namlit/Keyboard_PCB/Keyboard.kicad_pcb

## KiCad design Keyboard.kicad_pcb (2016-03-09)

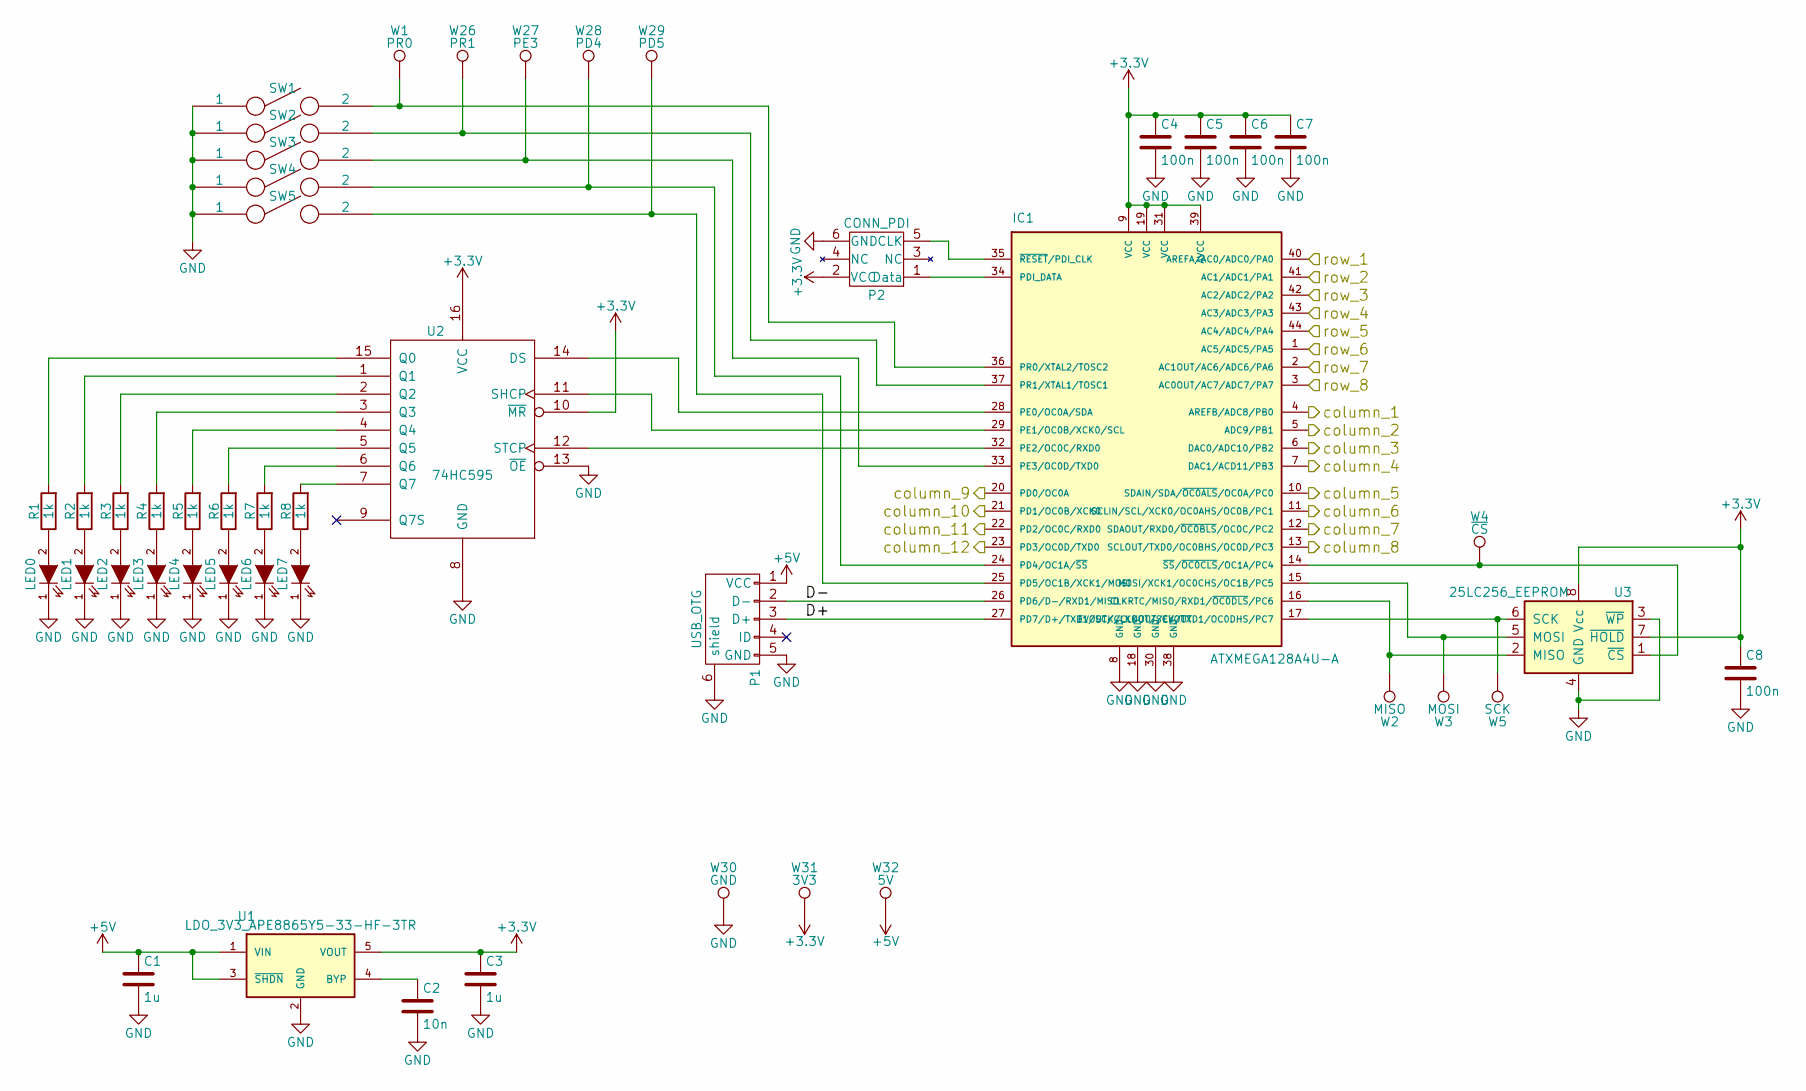
[picture p1: schematic keyboard_controller.sch]

Parts:
C1, C3: 1u; C_0603_HandSoldering; Manufacturer Part Number CL10B105KO8NNNC
C2: 10n; C_0603_HandSoldering; Manufacturer Part Number CL10B103KC8NNNC
C4, C5, C6, C7, C8: 100n; C_0603_HandSoldering; Manufacturer Part Number CL10B104KO8NNNC
IC1: ATXMEGA128A4U-A; TQFP_44_0.8mmPitch_handSoldering; Manufacturer Part Number ATXMEGA128A4U-AU
LED0, LED1, LED2, LED3, LED4, LED5: LED; LED_0603; Manufacturer Part Number LL-S194PUGC-2B
LED6, LED7: LED; LED_0603; Manufacturer Part Number LL-S194PVC-V1-2B
P1: USB_OTG; micro_USB_1981568-1; Manufacturer Part Number 1981568-1
P2: CONN_PDI; Pin_Header_Straight_2x03; Manufacturer Part Number T821106A1S100CEU
R1, R2, R3, R4, R5, R6, R7, R8: 1k; R_0603_HandSoldering; Manufacturer Part Number RC0603JR-071K
SW1, SW2, SW3, SW4, SW5: SPST; SPST_TACTM-613N-F; Manufacturer Part Number TACTM-613N-F
U1: LDO_3V3_APE8865Y5-33-HF-3TR; SOT-23-5; Manufacturer Part Number APE8865Y5-33-HF-3TR
U2: 74HC595; SOIC-16_3.9x9.9mm_Pitch1.27mm; Manufacturer Part Number 74HC595D.118
U3: 25LC256_EEPROM; SOIC-8_3.9x4.9mm_Pitch1.27mm; Manufacturer Part Number 25LC256-I/SN
W1: PR0; Measurement_Point_Round-TH_Big
W2: MISO; Measurement_Point_Round-TH_Big
W3: MOSI; Measurement_Point_Round-TH_Big
W4: ~CS; Measurement_Point_Round-TH_Big
W5: SCK; Measurement_Point_Round-TH_Big
W26: PR1; Measurement_Point_Round-TH_Big
W27: PE3; Measurement_Point_Round-TH_Big
W28: PD4; Measurement_Point_Round-TH_Big
W29: PD5; Measurement_Point_Round-TH_Big
W30: GND; Measurement_Point_Round-TH_Big
W31: 3V3; Measurement_Point_Round-TH_Big
W32: 5V; Measurement_Point_Round-TH_Big

Connections:
+3V3: C3.1, C4.1, C5.1, C6.1, C7.1, C8.1, IC1.9 (VCC), IC1.19 (VCC), IC1.31 (VCC), IC1.39 (AVCC), P2.2 (VCC), U1.5 (VOUT), U2.10 (~MR), U2.16 (VCC), U3.7 (~HOLD), U3.8 (Vcc), W31.1
+5V: C1.1, P1.1 (VCC), U1.1 (VIN), U1.3 (~SHDN~), W32.1
/keyboard_controller/D+: IC1.27 (PD7/D+/TXD1/SCK/CLKOUT/EVOUT), P1.3 (D+)
/keyboard_controller/D-: IC1.26 (PD6/D-/RXD1/MISO), P1.2 (D-)
/keyboard_controller/column_1: IC1.4 (AREFB/ADC8/PB0); also elsewhere on the board
/keyboard_controller/column_2: IC1.5 (ADC9/PB1); also elsewhere on the board
/keyboard_controller/column_3: IC1.6 (DAC0/ADC10/PB2); also elsewhere on the board
/keyboard_controller/column_4: IC1.7 (DAC1/ACD11/PB3); also elsewhere on the board
/keyboard_controller/column_5: IC1.10 (SDAIN/SDA/~OC0ALS~/OC0A/PC0); also elsewhere on the board
/keyboard_controller/column_6: IC1.11 (SCLIN/SCL/XCK0/OC0AHS/OC0B/PC1); also elsewhere on the board
/keyboard_controller/column_7: IC1.12 (SDAOUT/RXD0/~OC0BLS~/OC0C/PC2); also elsewhere on the board
/keyboard_controller/column_8: IC1.13 (SCLOUT/TXD0/OC0BHS/OC0D/PC3); also elsewhere on the board
/keyboard_controller/column_9: IC1.20 (PD0/OC0A); also elsewhere on the board
/keyboard_controller/column_10: IC1.21 (PD1/OC0B/XCK0); also elsewhere on the board
/keyboard_controller/column_11: IC1.22 (PD2/OC0C/RXD0); also elsewhere on the board
/keyboard_controller/column_12: IC1.23 (PD3/OC0D/TXD0); also elsewhere on the board
/keyboard_controller/row_1: IC1.40 (AREFA/AC0/ADC0/PA0); also elsewhere on the board
/keyboard_controller/row_2: IC1.41 (AC1/ADC1/PA1); also elsewhere on the board
/keyboard_controller/row_3: IC1.42 (AC2/ADC2/PA2); also elsewhere on the board
/keyboard_controller/row_4: IC1.43 (AC3/ADC3/PA3); also elsewhere on the board
/keyboard_controller/row_5: IC1.44 (AC4/ADC4/PA4); also elsewhere on the board
/keyboard_controller/row_6: IC1.1 (AC5/ADC5/PA5); also elsewhere on the board
/keyboard_controller/row_7: IC1.2 (AC1OUT/AC6/ADC6/PA6); also elsewhere on the board
/keyboard_controller/row_8: IC1.3 (AC0OUT/AC7/ADC7/PA7); also elsewhere on the board
GND: C1.2, C2.2, C3.2, C4.2, C5.2, C6.2, C7.2, C8.2, IC1.8 (GND), IC1.18 (GND), IC1.30 (GND), IC1.38 (GND), LED0.1 (K), LED1.1 (K), LED2.1 (K), LED3.1 (K), LED4.1 (K), LED5.1 (K), LED6.1 (K), LED7.1 (K), P1.5 (GND), P1.6 (shield), P2.6 (GND), SW1.1, SW2.1, SW3.1, SW4.1, SW5.1, U1.2 (GND), U2.8 (GND), U2.13 (~OE), U3.3 (~WP), U3.4 (GND), W30.1
unnamed: C2.1, U1.4 (BYP)
unnamed: IC1.14 (~SS~/~OC0CLS~/OC1A/PC4), U3.1 (~CS), W4.1
unnamed: IC1.15 (MOSI/XCK1/OC0CHS/OC1B/PC5), U3.5 (MOSI), W3.1
unnamed: IC1.16 (CLKRTC/MISO/RXD1/~OC0DLS~/PC6), U3.2 (MISO), W2.1
unnamed: IC1.17 (EVOUT/CLKOUT/SCK/TXD1/OC0DHS/PC7), U3.6 (SCK), W5.1
unnamed: IC1.24 (PD4/OC1A/~SS~), SW4.2, W28.1
unnamed: IC1.25 (PD5/OC1B/XCK1/MOSI), SW5.2, W29.1
unnamed: IC1.28 (PE0/OC0A/SDA), U2.14 (DS)
unnamed: IC1.29 (PE1/OC0B/XCK0/SCL), U2.11 (SHCP)
unnamed: IC1.32 (PE2/OC0C/RXD0), U2.12 (STCP)
unnamed: IC1.33 (PE3/OC0D/TXD0), SW3.2, W27.1
unnamed: IC1.34 (PDI_DATA), P2.1 (Data)
unnamed: IC1.35 (~RESET~/PDI_CLK), P2.5 (CLK)
unnamed: IC1.36 (PR0/XTAL2/TOSC2), SW1.2, W1.1
unnamed: IC1.37 (PR1/XTAL1/TOSC1), SW2.2, W26.1
unnamed: LED0.2 (A), R1.1
unnamed: LED1.2 (A), R2.1
unnamed: LED2.2 (A), R3.1
unnamed: LED3.2 (A), R4.1
unnamed: LED4.2 (A), R5.1
unnamed: LED5.2 (A), R6.1
unnamed: LED6.2 (A), R7.1
unnamed: LED7.2 (A), R8.1
unnamed: R1.2, U2.15 (Q0)
unnamed: R2.2, U2.1 (Q1)
unnamed: R3.2, U2.2 (Q2)
unnamed: R4.2, U2.3 (Q3)
unnamed: R5.2, U2.4 (Q4)
unnamed: R6.2, U2.5 (Q5)
unnamed: R7.2, U2.6 (Q6)
unnamed: R8.2, U2.7 (Q7)

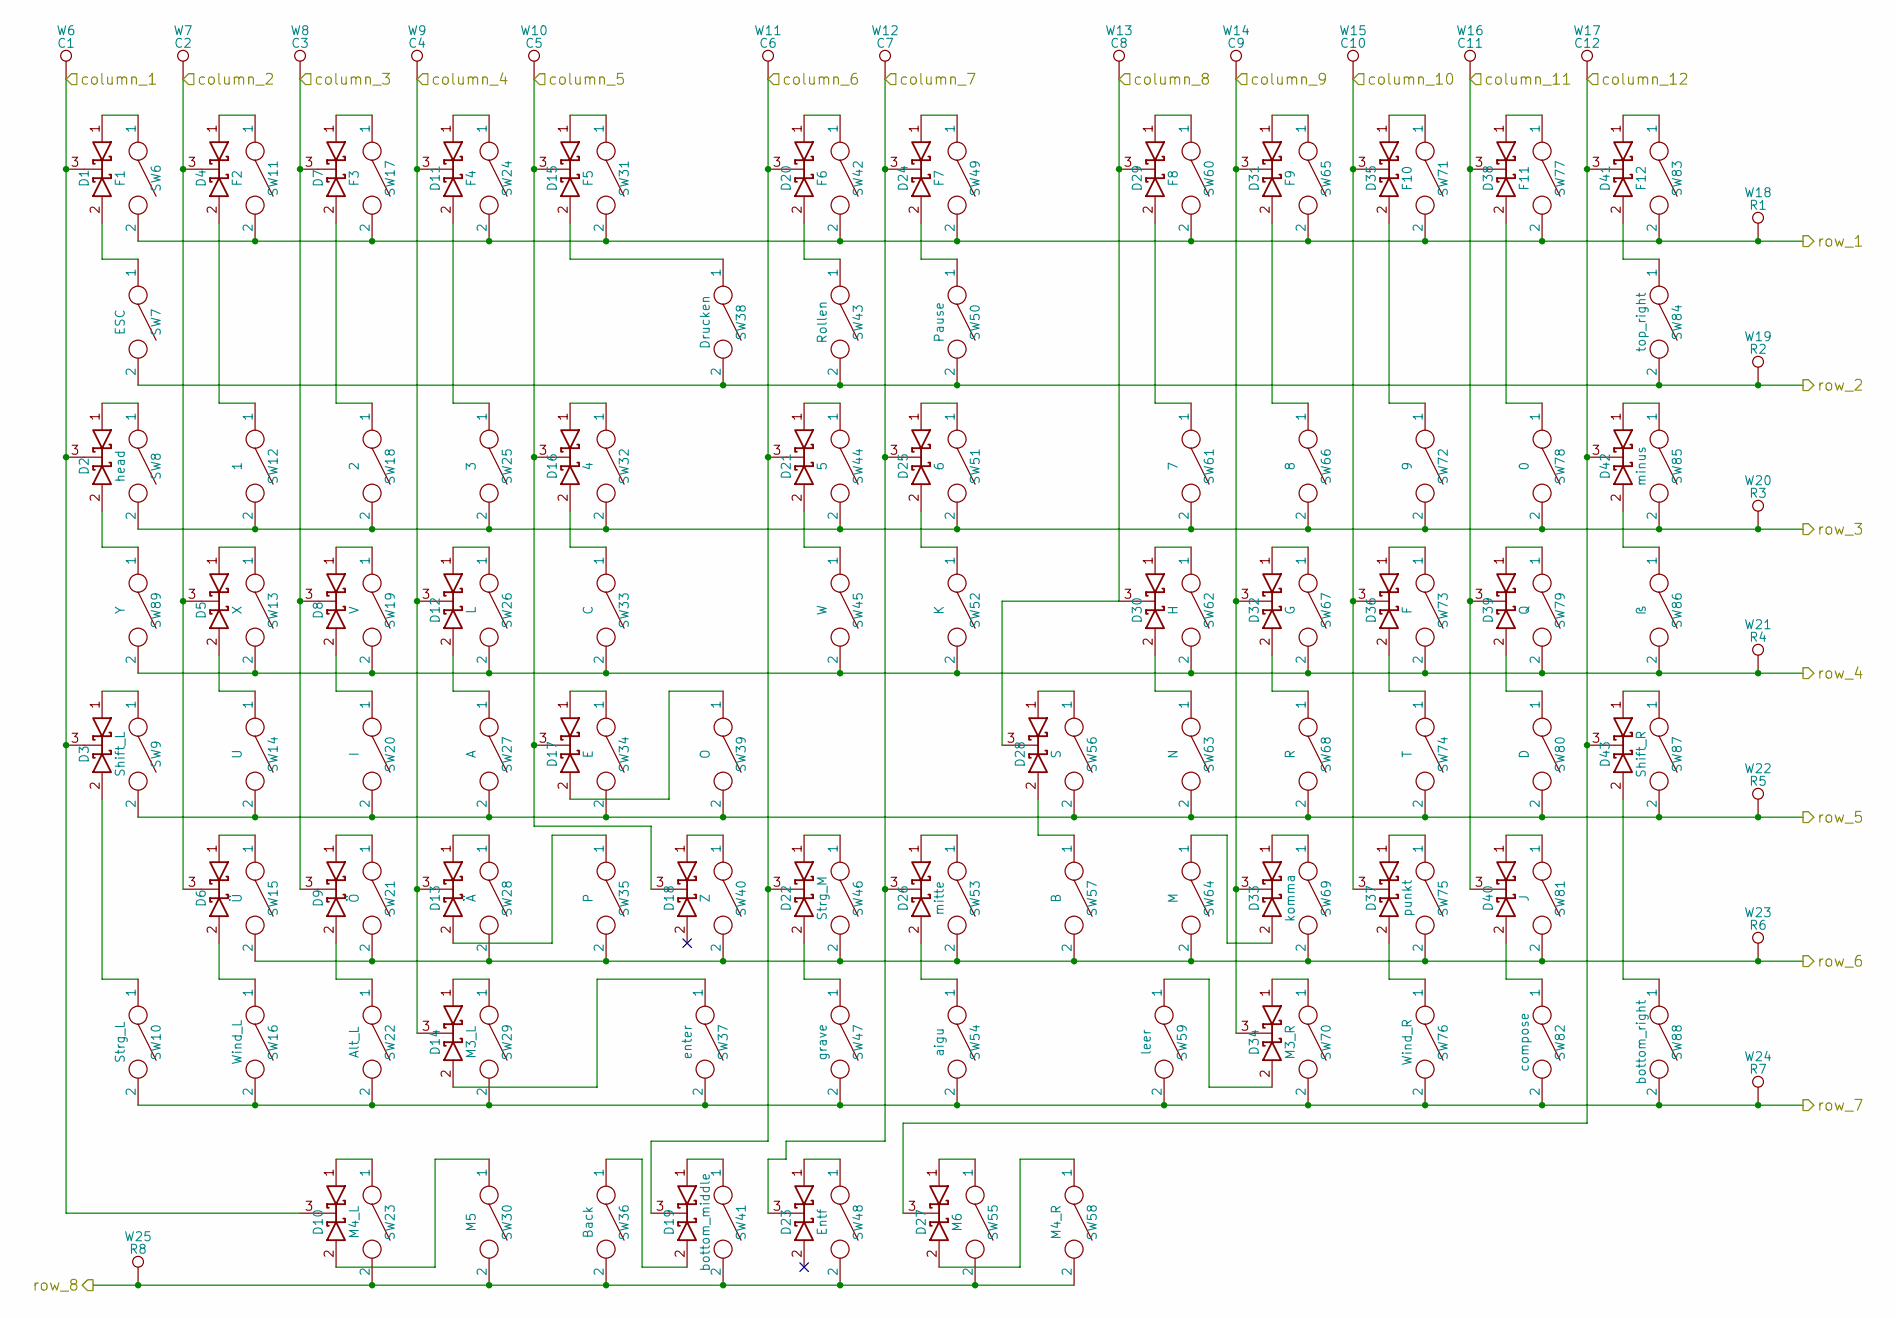
[picture p2: schematic keyboard_matrix.sch]

Parts:
D1, D2, D3, D4, D5, D6, D7, D8, D9, D10, D11, D12, D13, D14, D15, D16, D17, D18, D19, D20, D21, D22, D23, D24, D25, D26, D27, D28, D29, D30, D31, D32, D33, D34, D35, D36, D37, D38, D39, D40, D41, D42, D43: D_Schottky_x2_KCom_AAK; SOT-23; Manufacturer Part Number BAT54C.215
SW6: F1; Cherry_MX
SW7: ESC; Cherry_MX
SW8: head; Cherry_MX
SW9: Shift_L; Cherry_MX_double_vertical
SW10: Strg_L; Cherry_MX
SW11: F2; Cherry_MX
SW12: 1; Cherry_MX
SW13: X; Cherry_MX
SW14: U; Cherry_MX
SW15: Ü; Cherry_MX
SW16: Wind_L; Cherry_MX
SW17: F3; Cherry_MX
SW18: 2; Cherry_MX
SW19: V; Cherry_MX
SW20: I; Cherry_MX
SW21: Ö; Cherry_MX
SW22: Alt_L; Cherry_MX
SW23: M4_L; Cherry_MX
SW24: F4; Cherry_MX
SW25: 3; Cherry_MX
SW26: L; Cherry_MX
SW27: A; Cherry_MX
SW28: Ä; Cherry_MX
SW29: M3_L; Cherry_MX
SW30: M5; Cherry_MX
SW31: F5; Cherry_MX
SW32: 4; Cherry_MX
SW33: C; Cherry_MX
SW34: E; Cherry_MX
SW35: P; Cherry_MX
SW36: Back; Cherry_MX
SW37: enter; Cherry_MX_double_horizontal
SW38: Drucken; Cherry_MX
SW39: O; Cherry_MX
SW40: Z; Cherry_MX
SW41: bottom_middle; Cherry_MX
SW42: F6; Cherry_MX
SW43: Rollen; Cherry_MX
SW44: 5; Cherry_MX
SW45: W; Cherry_MX
SW46: Strg_M; Cherry_MX
SW47: grave; Cherry_MX
SW48: Entf; Cherry_MX
SW49: F7; Cherry_MX
SW50: Pause; Cherry_MX
SW51: 6; Cherry_MX
SW52: K; Cherry_MX
SW53: mitte; Cherry_MX
SW54: aigu; Cherry_MX
SW55: M6; Cherry_MX
SW56: S; Cherry_MX
SW57: B; Cherry_MX
SW58: M4_R; Cherry_MX
SW59: leer; Cherry_MX_double_horizontal
SW60: F8; Cherry_MX
SW61: 7; Cherry_MX
SW62: H; Cherry_MX
SW63: N; Cherry_MX
SW64: M; Cherry_MX
SW65: F9; Cherry_MX
SW66: 8; Cherry_MX
SW67: G; Cherry_MX
SW68: R; Cherry_MX
SW69: komma; Cherry_MX
SW70: M3_R; Cherry_MX
SW71: F10; Cherry_MX
SW72: 9; Cherry_MX
SW73: F; Cherry_MX
SW74: T; Cherry_MX
SW75: punkt; Cherry_MX
SW76: Wind_R; Cherry_MX
SW77: F11; Cherry_MX
SW78: 0; Cherry_MX
SW79: Q; Cherry_MX
SW80: D; Cherry_MX
SW81: J; Cherry_MX
SW82: compose; Cherry_MX
SW83: F12; Cherry_MX
SW84: top_right; Cherry_MX
SW85: minus; Cherry_MX
SW86: ß; Cherry_MX
SW87: Shift_R; Cherry_MX_double_vertical
SW88: bottom_right; Cherry_MX
SW89: Y; Cherry_MX
W6: C1; Measurement_Point_Round-TH_Big
W7: C2; Measurement_Point_Round-TH_Big
W8: C3; Measurement_Point_Round-TH_Big
W9: C4; Measurement_Point_Round-TH_Big
W10: C5; Measurement_Point_Round-TH_Big
W11: C6; Measurement_Point_Round-TH_Big
W12: C7; Measurement_Point_Round-TH_Big
W13: C8; Measurement_Point_Round-TH_Big
W14: C9; Measurement_Point_Round-TH_Big
W15: C10; Measurement_Point_Round-TH_Big
W16: C11; Measurement_Point_Round-TH_Big
W17: C12; Measurement_Point_Round-TH_Big
W18: R1; Measurement_Point_Round-TH_Big
W19: R2; Measurement_Point_Round-TH_Big
W20: R3; Measurement_Point_Round-TH_Big
W21: R4; Measurement_Point_Round-TH_Big
W22: R5; Measurement_Point_Round-TH_Big
W23: R6; Measurement_Point_Round-TH_Big
W24: R7; Measurement_Point_Round-TH_Big
W25: R8; Measurement_Point_Round-TH_Big

Connections:
/keyboard_controller/column_1: D1.3 (K), D2.3 (K), D3.3 (K), D10.3 (K), W6.1; also elsewhere on the board
/keyboard_controller/column_2: D4.3 (K), D5.3 (K), D6.3 (K), W7.1; also elsewhere on the board
/keyboard_controller/column_3: D7.3 (K), D8.3 (K), D9.3 (K), W8.1; also elsewhere on the board
/keyboard_controller/column_4: D11.3 (K), D12.3 (K), D13.3 (K), D14.3 (K), W9.1; also elsewhere on the board
/keyboard_controller/column_5: D15.3 (K), D16.3 (K), D17.3 (K), D18.3 (K), W10.1; also elsewhere on the board
/keyboard_controller/column_6: D19.3 (K), D20.3 (K), D21.3 (K), D22.3 (K), W11.1; also elsewhere on the board
/keyboard_controller/column_7: D23.3 (K), D24.3 (K), D25.3 (K), D26.3 (K), W12.1; also elsewhere on the board
/keyboard_controller/column_8: D28.3 (K), D29.3 (K), D30.3 (K), W13.1; also elsewhere on the board
/keyboard_controller/column_9: D31.3 (K), D32.3 (K), D33.3 (K), D34.3 (K), W14.1; also elsewhere on the board
/keyboard_controller/column_10: D35.3 (K), D36.3 (K), D37.3 (K), W15.1; also elsewhere on the board
/keyboard_controller/column_11: D38.3 (K), D39.3 (K), D40.3 (K), W16.1; also elsewhere on the board
/keyboard_controller/column_12: D27.3 (K), D41.3 (K), D42.3 (K), D43.3 (K), W17.1; also elsewhere on the board
/keyboard_controller/row_1: SW6.2, SW11.2, SW17.2, SW24.2, SW31.2, SW42.2, SW49.2, SW60.2, SW65.2, SW71.2, SW77.2, SW83.2, W18.1; also elsewhere on the board
/keyboard_controller/row_2: SW7.2, SW38.2, SW43.2, SW50.2, SW84.2, W19.1; also elsewhere on the board
/keyboard_controller/row_3: SW8.2, SW12.2, SW18.2, SW25.2, SW32.2, SW44.2, SW51.2, SW61.2, SW66.2, SW72.2, SW78.2, SW85.2, W20.1; also elsewhere on the board
/keyboard_controller/row_4: SW13.2, SW19.2, SW26.2, SW33.2, SW45.2, SW52.2, SW62.2, SW67.2, SW73.2, SW79.2, SW86.2, SW89.2, W21.1; also elsewhere on the board
/keyboard_controller/row_5: SW9.2, SW14.2, SW20.2, SW27.2, SW34.2, SW39.2, SW56.2, SW63.2, SW68.2, SW74.2, SW80.2, SW87.2, W22.1; also elsewhere on the board
/keyboard_controller/row_6: SW15.2, SW21.2, SW28.2, SW35.2, SW40.2, SW46.2, SW53.2, SW57.2, SW64.2, SW69.2, SW75.2, SW81.2, W23.1; also elsewhere on the board
/keyboard_controller/row_7: SW10.2, SW16.2, SW22.2, SW29.2, SW37.2, SW47.2, SW54.2, SW59.2, SW70.2, SW76.2, SW82.2, SW88.2, W24.1; also elsewhere on the board
/keyboard_controller/row_8: SW23.2, SW30.2, SW36.2, SW41.2, SW48.2, SW55.2, SW58.2, W25.1; also elsewhere on the board
unnamed: D1.1 (A), SW6.1
unnamed: D1.2 (A), SW7.1
unnamed: D2.1 (A), SW8.1
unnamed: D2.2 (A), SW89.1
unnamed: D3.1 (A), SW9.1
unnamed: D3.2 (A), SW10.1
unnamed: D4.1 (A), SW11.1
unnamed: D4.2 (A), SW12.1
unnamed: D5.1 (A), SW13.1
unnamed: D5.2 (A), SW14.1
unnamed: D6.1 (A), SW15.1
unnamed: D6.2 (A), SW16.1
unnamed: D7.1 (A), SW17.1
unnamed: D7.2 (A), SW18.1
unnamed: D8.1 (A), SW19.1
unnamed: D8.2 (A), SW20.1
unnamed: D9.1 (A), SW21.1
unnamed: D9.2 (A), SW22.1
unnamed: D10.1 (A), SW23.1
unnamed: D10.2 (A), SW30.1
unnamed: D11.1 (A), SW24.1
unnamed: D11.2 (A), SW25.1
unnamed: D12.1 (A), SW26.1
unnamed: D12.2 (A), SW27.1
unnamed: D13.1 (A), SW28.1
unnamed: D13.2 (A), SW35.1
unnamed: D14.1 (A), SW29.1
unnamed: D14.2 (A), SW37.1
unnamed: D15.1 (A), SW31.1
unnamed: D15.2 (A), SW38.1
unnamed: D16.1 (A), SW32.1
unnamed: D16.2 (A), SW33.1
unnamed: D17.1 (A), SW34.1
unnamed: D17.2 (A), SW39.1
unnamed: D18.1 (A), SW40.1
unnamed: D19.1 (A), SW41.1
unnamed: D19.2 (A), SW36.1
unnamed: D20.1 (A), SW42.1
unnamed: D20.2 (A), SW43.1
unnamed: D21.1 (A), SW44.1
unnamed: D21.2 (A), SW45.1
unnamed: D22.1 (A), SW46.1
unnamed: D22.2 (A), SW47.1
unnamed: D23.1 (A), SW48.1
unnamed: D24.1 (A), SW49.1
unnamed: D24.2 (A), SW50.1
unnamed: D25.1 (A), SW51.1
unnamed: D25.2 (A), SW52.1
unnamed: D26.1 (A), SW53.1
unnamed: D26.2 (A), SW54.1
unnamed: D27.1 (A), SW55.1
unnamed: D27.2 (A), SW58.1
unnamed: D28.1 (A), SW56.1
unnamed: D28.2 (A), SW57.1
unnamed: D29.1 (A), SW60.1
unnamed: D29.2 (A), SW61.1
unnamed: D30.1 (A), SW62.1
unnamed: D30.2 (A), SW63.1
unnamed: D31.1 (A), SW65.1
unnamed: D31.2 (A), SW66.1
unnamed: D32.1 (A), SW67.1
unnamed: D32.2 (A), SW68.1
unnamed: D33.1 (A), SW69.1
unnamed: D33.2 (A), SW64.1
unnamed: D34.1 (A), SW70.1
unnamed: D34.2 (A), SW59.1
unnamed: D35.1 (A), SW71.1
unnamed: D35.2 (A), SW72.1
unnamed: D36.1 (A), SW73.1
unnamed: D36.2 (A), SW74.1
unnamed: D37.1 (A), SW75.1
unnamed: D37.2 (A), SW76.1
unnamed: D38.1 (A), SW77.1
unnamed: D38.2 (A), SW78.1
unnamed: D39.1 (A), SW79.1
unnamed: D39.2 (A), SW80.1
unnamed: D40.1 (A), SW81.1
unnamed: D40.2 (A), SW82.1
unnamed: D41.1 (A), SW83.1
unnamed: D41.2 (A), SW84.1
unnamed: D42.1 (A), SW85.1
unnamed: D42.2 (A), SW86.1
unnamed: D43.1 (A), SW87.1
unnamed: D43.2 (A), SW88.1

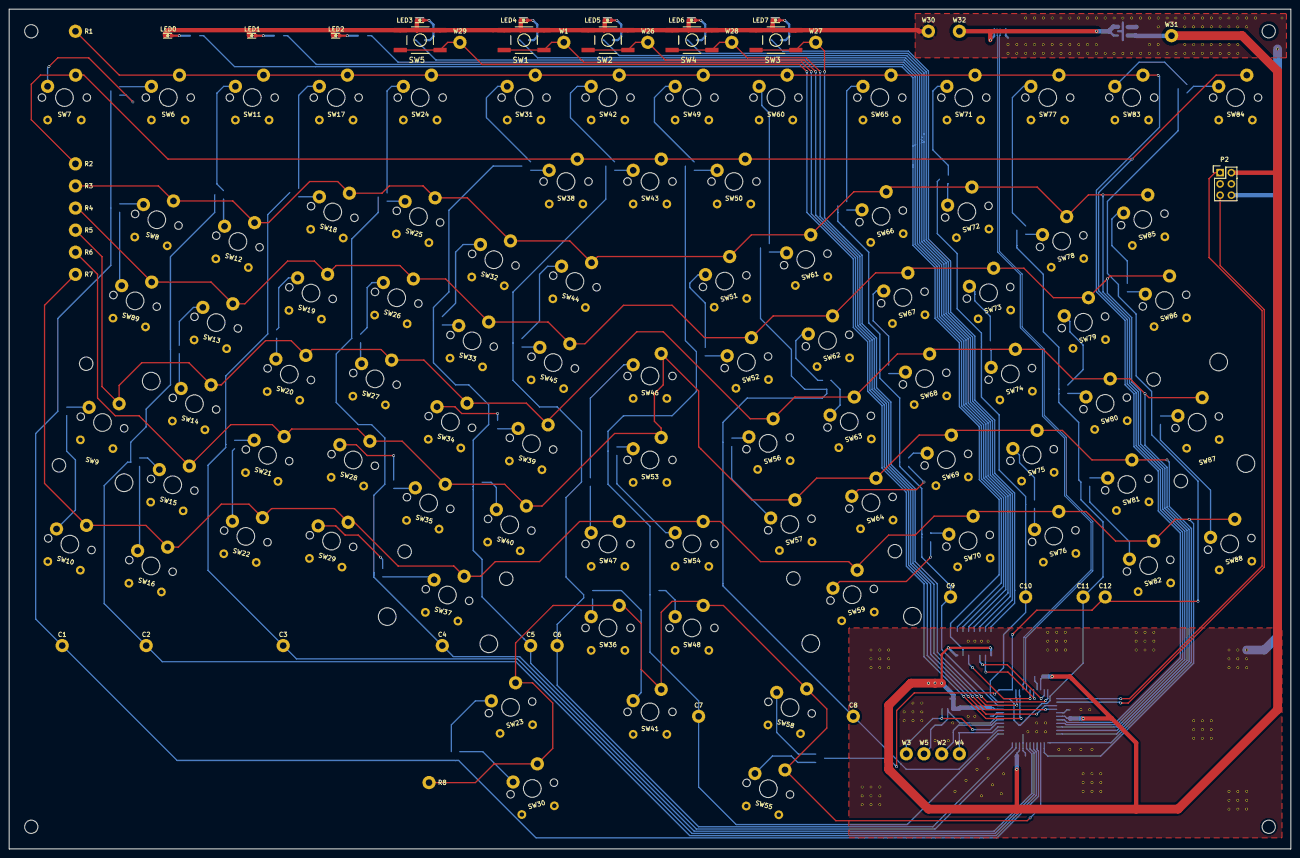
[picture p3: board Keyboard.kicad_pcb from above]

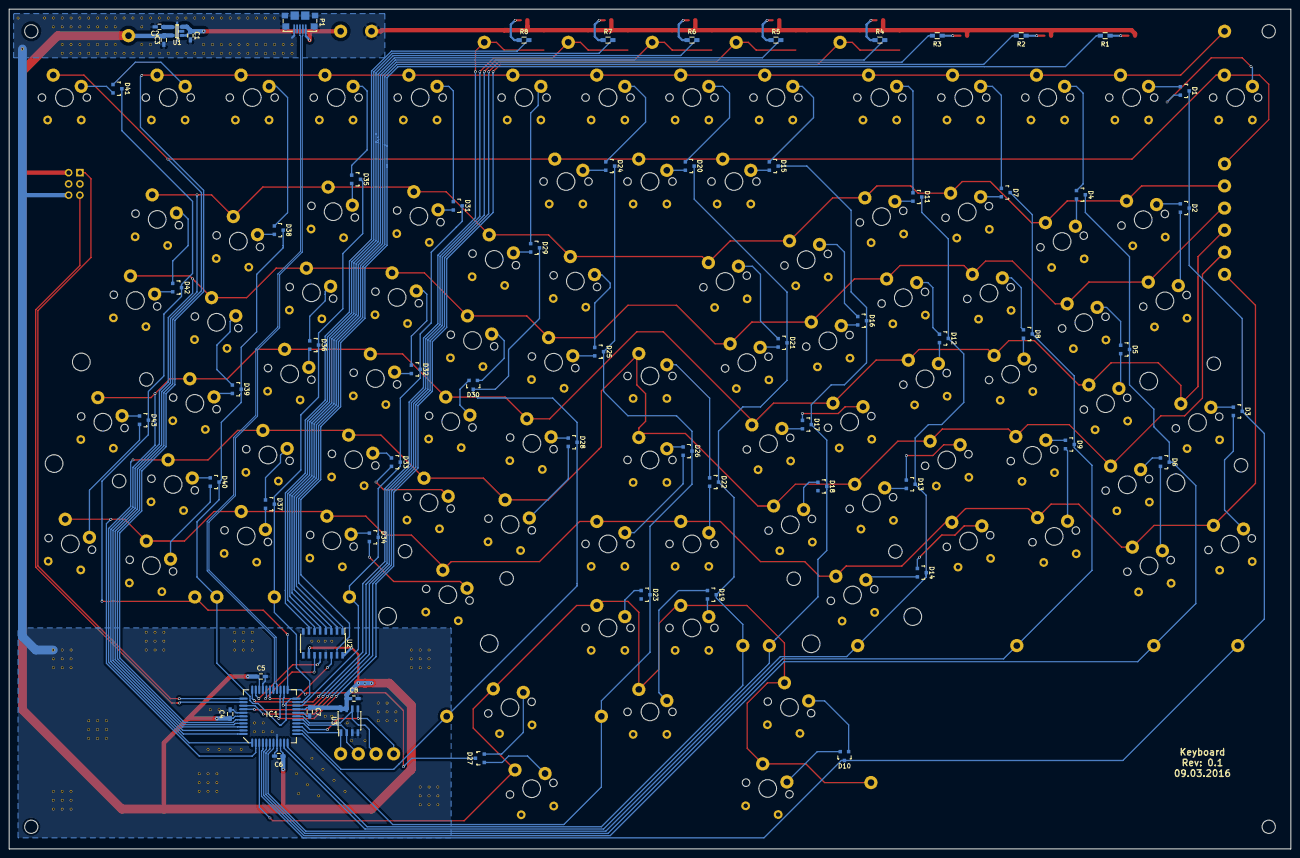
[picture p4: board Keyboard.kicad_pcb from below]

Board: 2 copper layers, 290.0 x 190.0 mm, 194 parts (64 on the bottom side), 140 nets.
